ljktofly/-Aurix-/英飞凌 Aurix TC2XX_TC3XX学习板/TC2XX&TC3XX_主板原理图.pdf

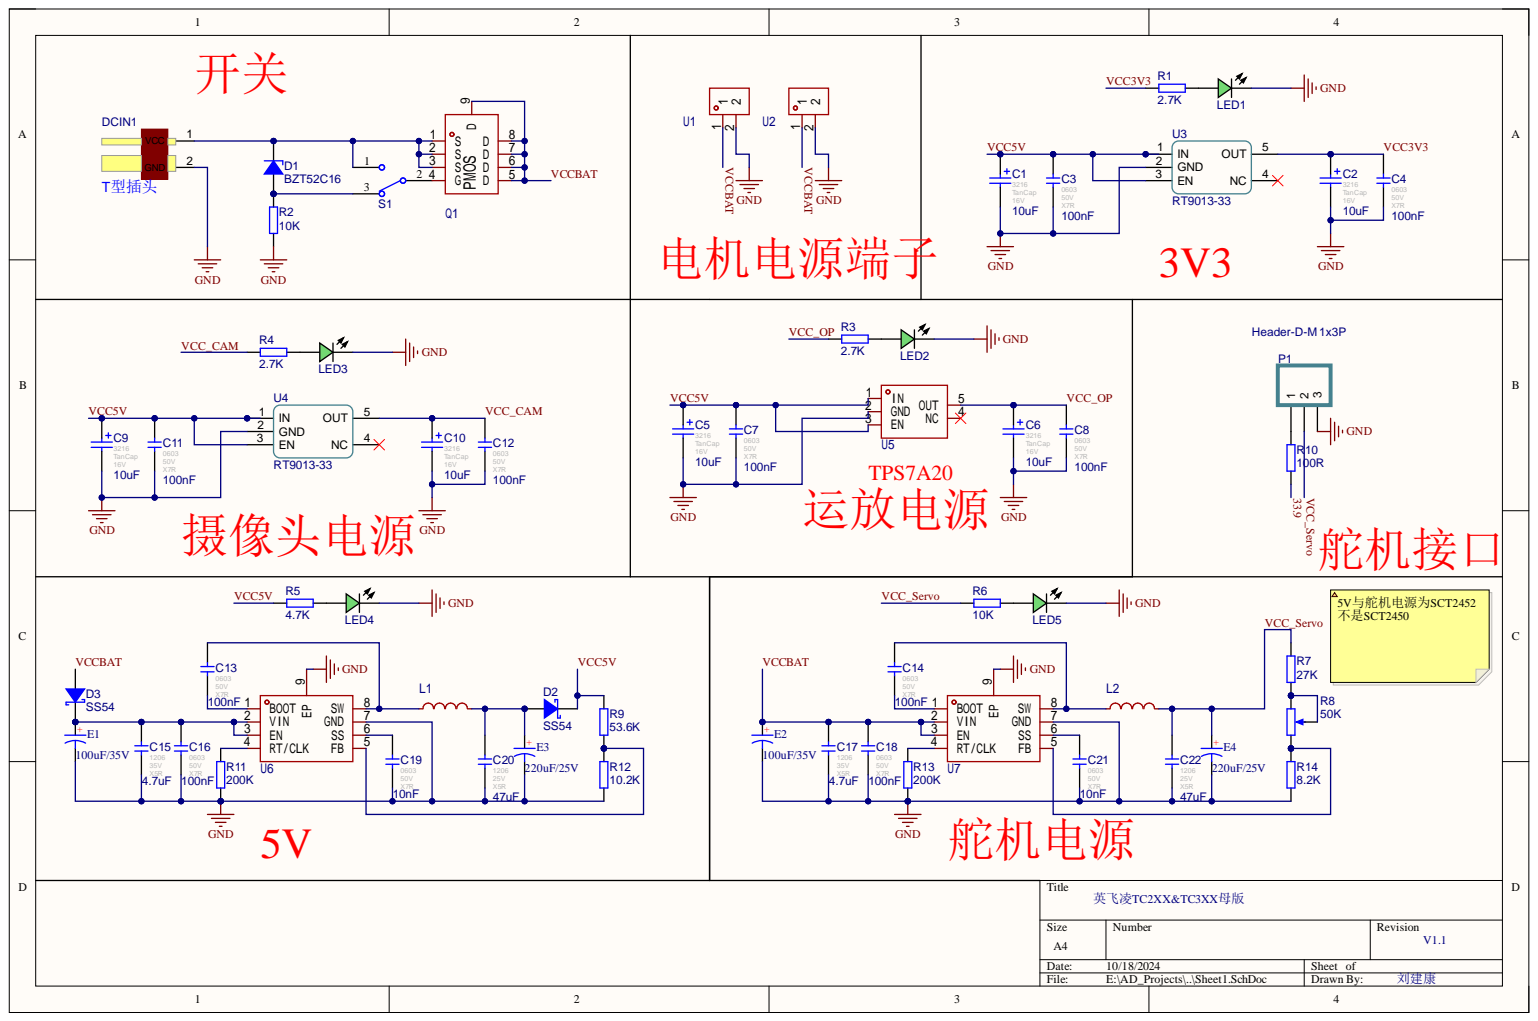
[picture p24: page 1]

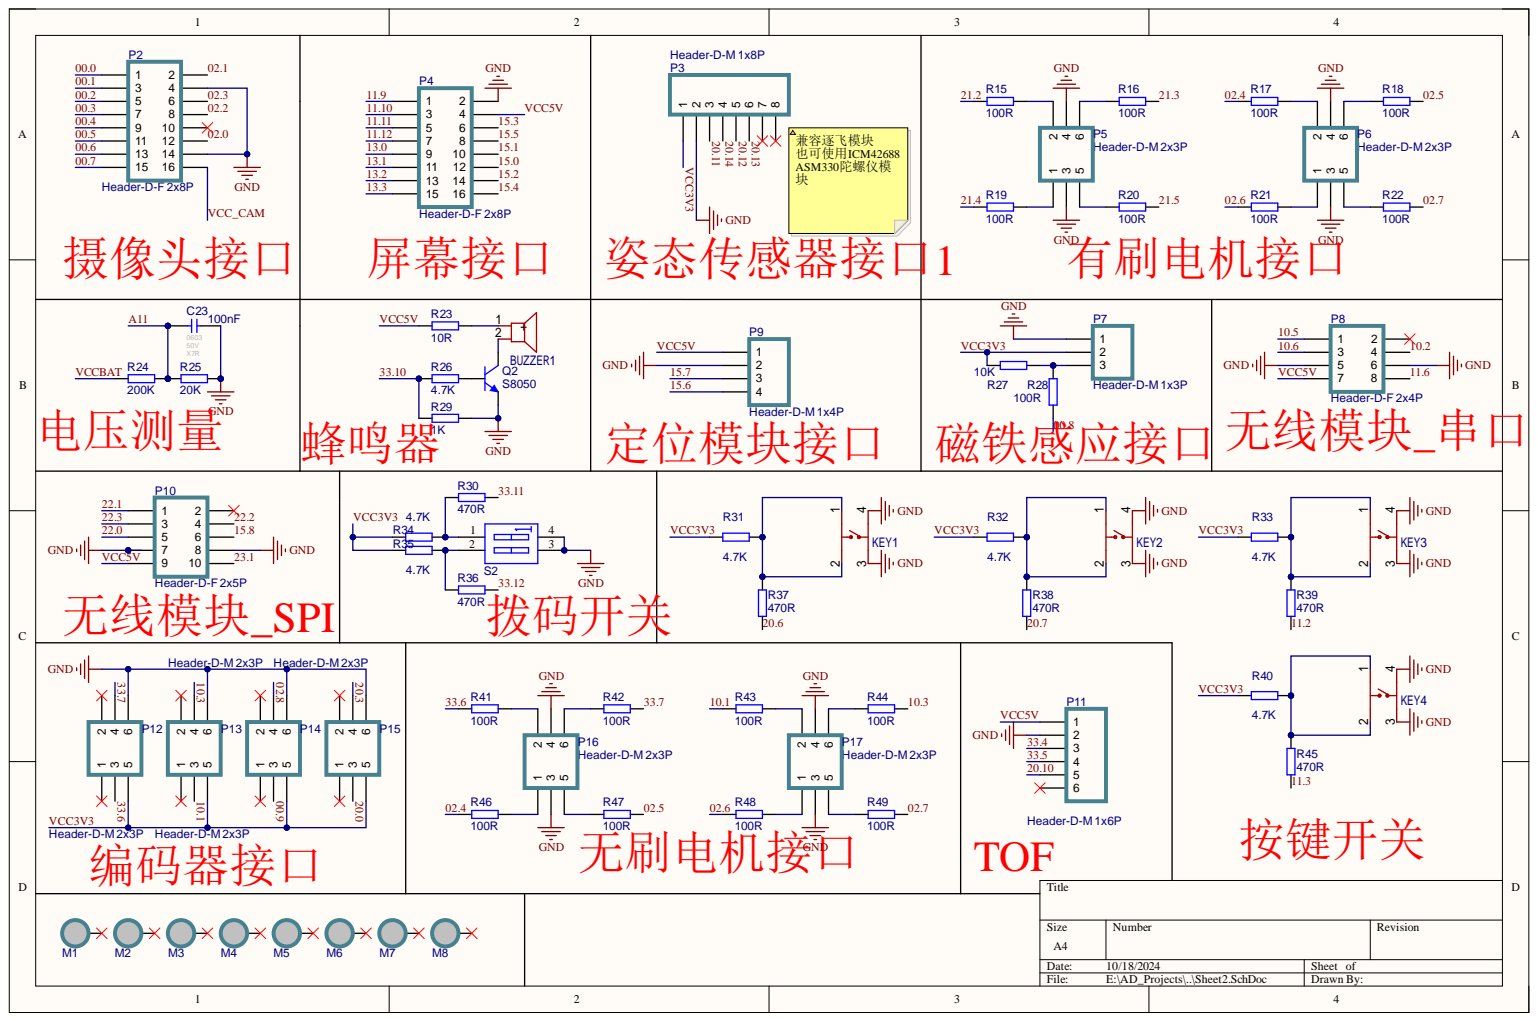
[picture p25: page 2]

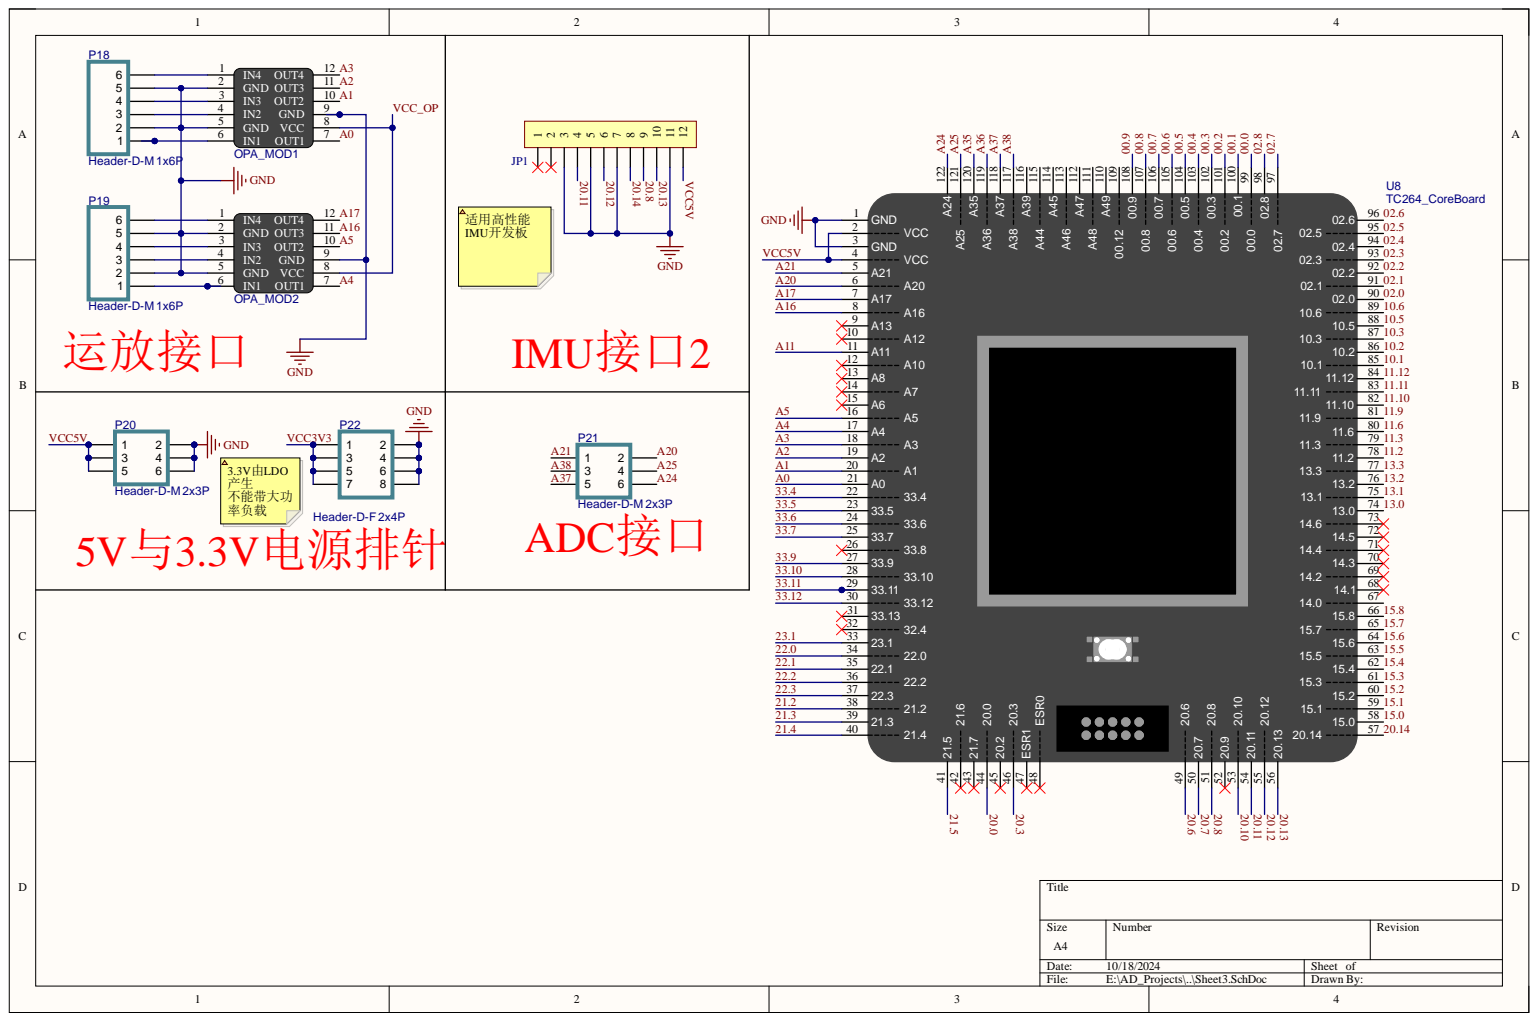
[picture p26: page 3]

3 1 0
4 9
