ljktofly/-Aurix-/英飞凌 Aurix TC2XX_TC3XX学习板/TC2XX&TC3XX_主板尺寸图.pdf

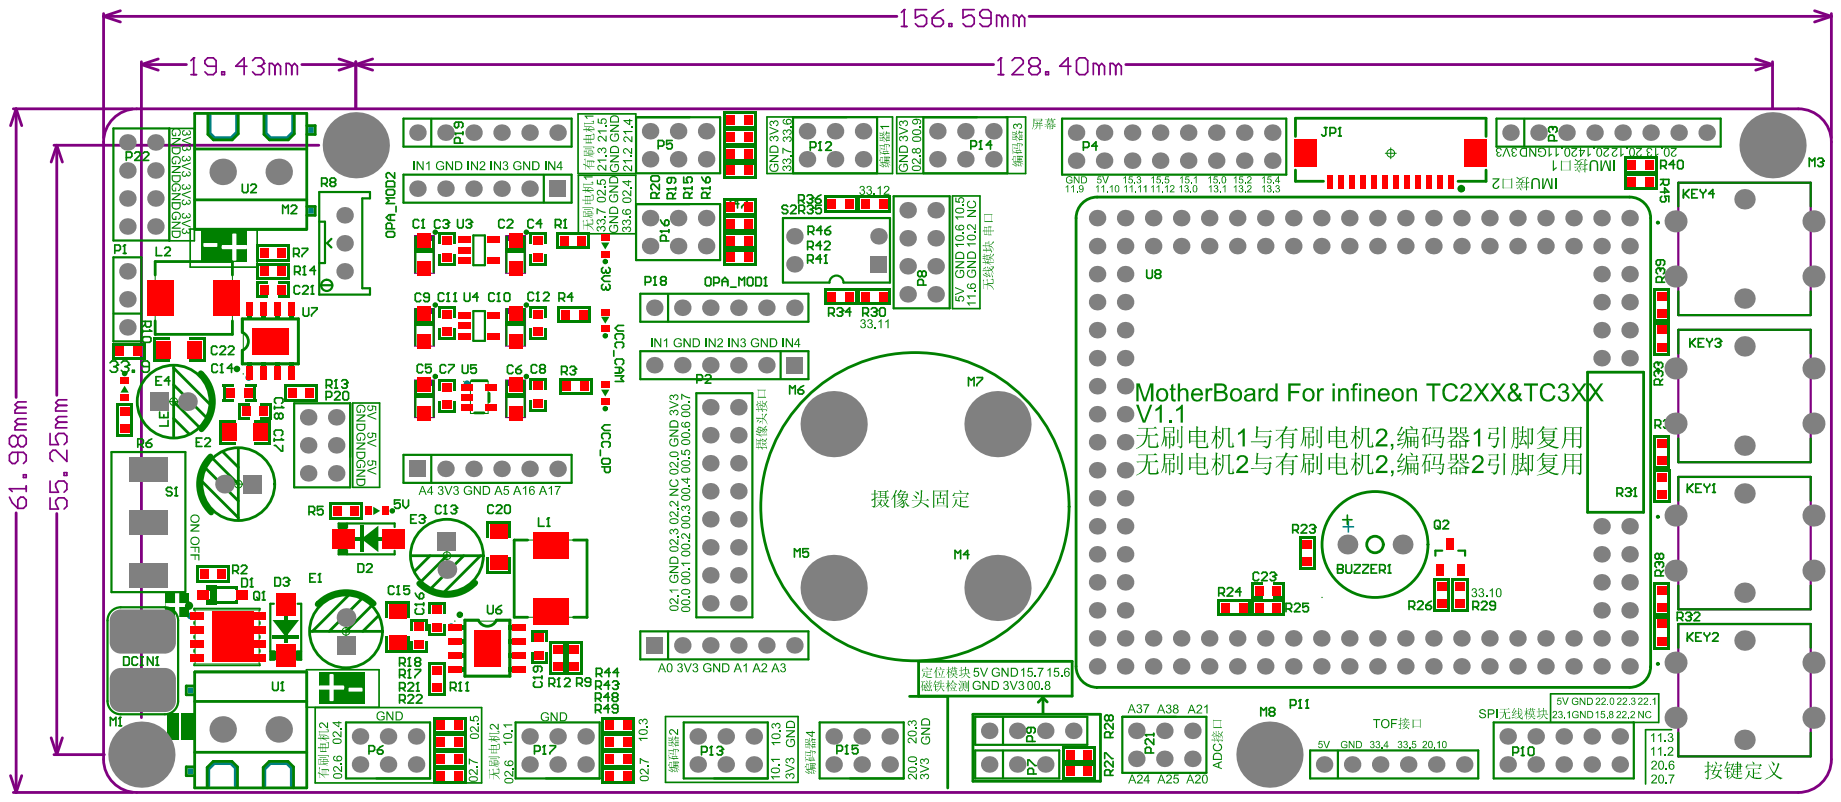
[picture p27: page 1]
