ljktofly/-Aurix-/英飞凌 Aurix TC2XX_TC3XX学习板/TC2XX&TC3XX_主板正面丝印_主板正面位号_主板背面丝印.pdf

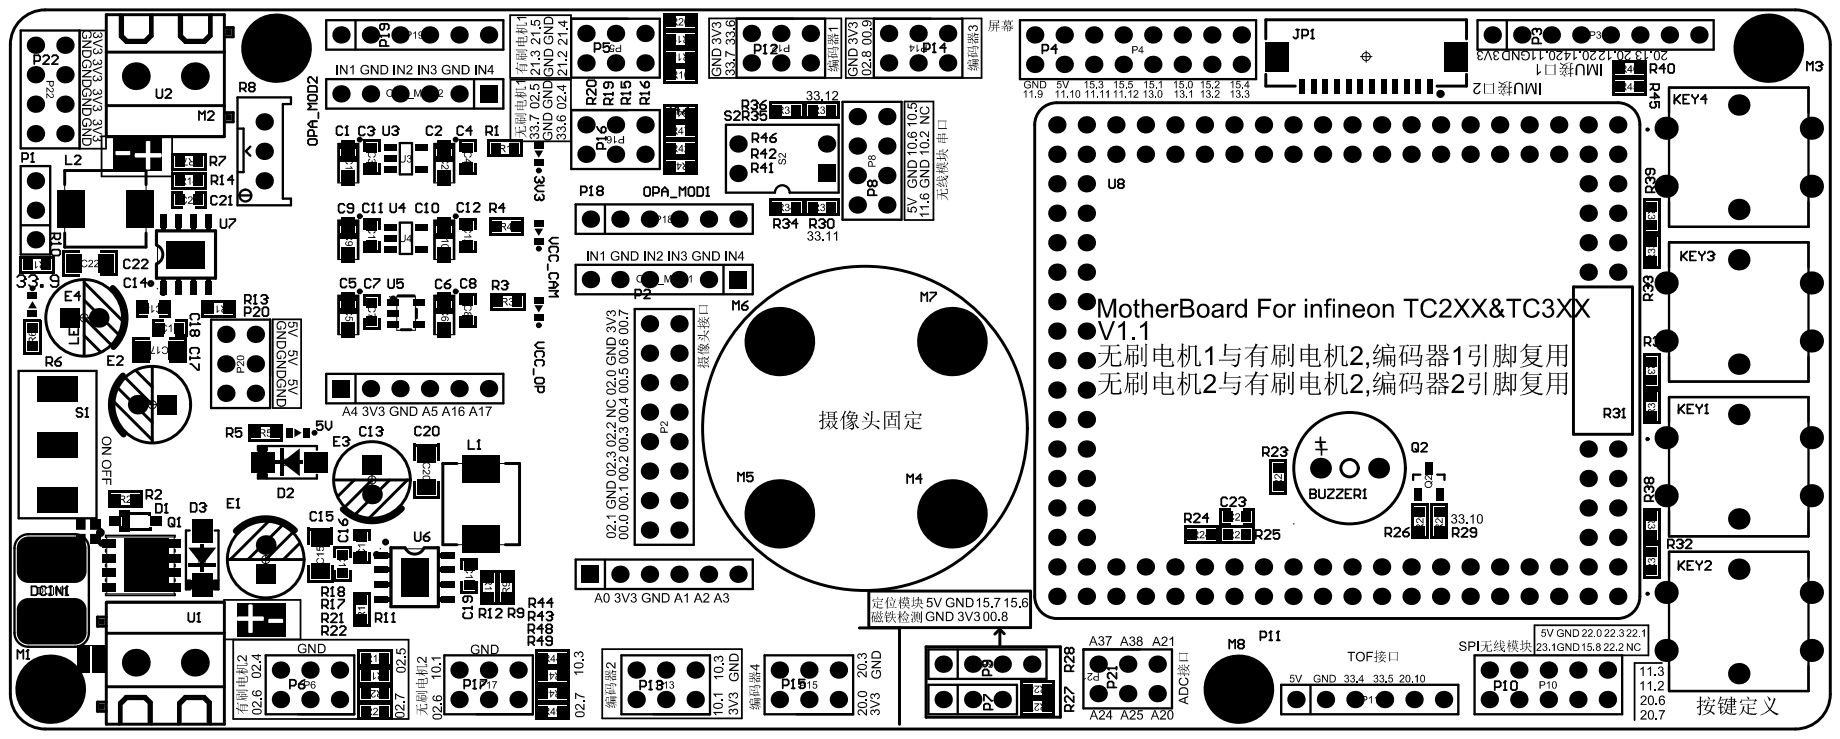
[picture p28: page 1]

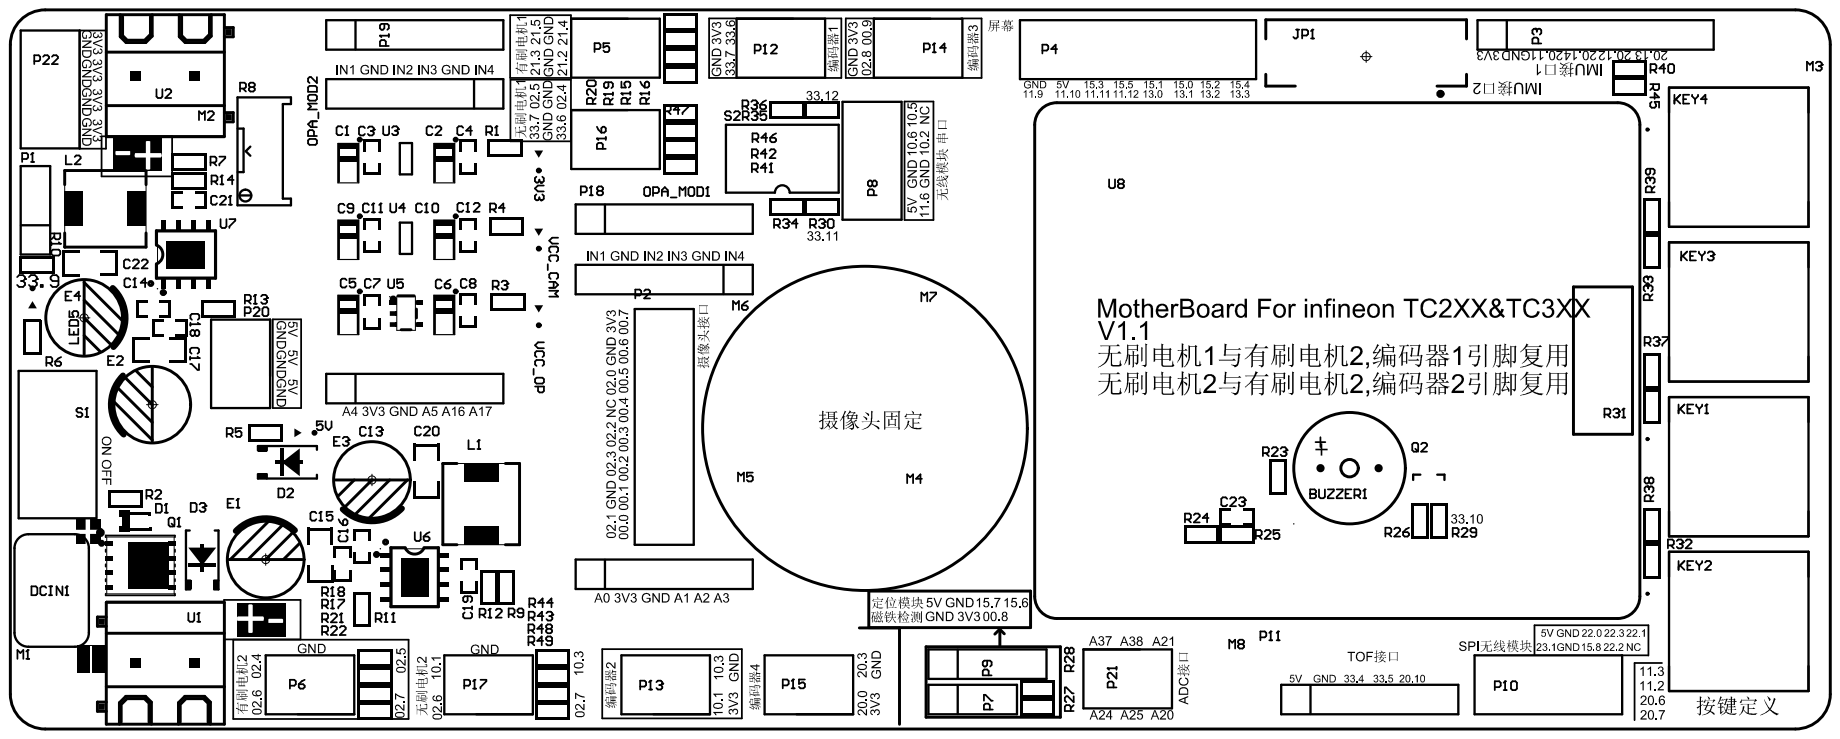
[picture p29: page 2]

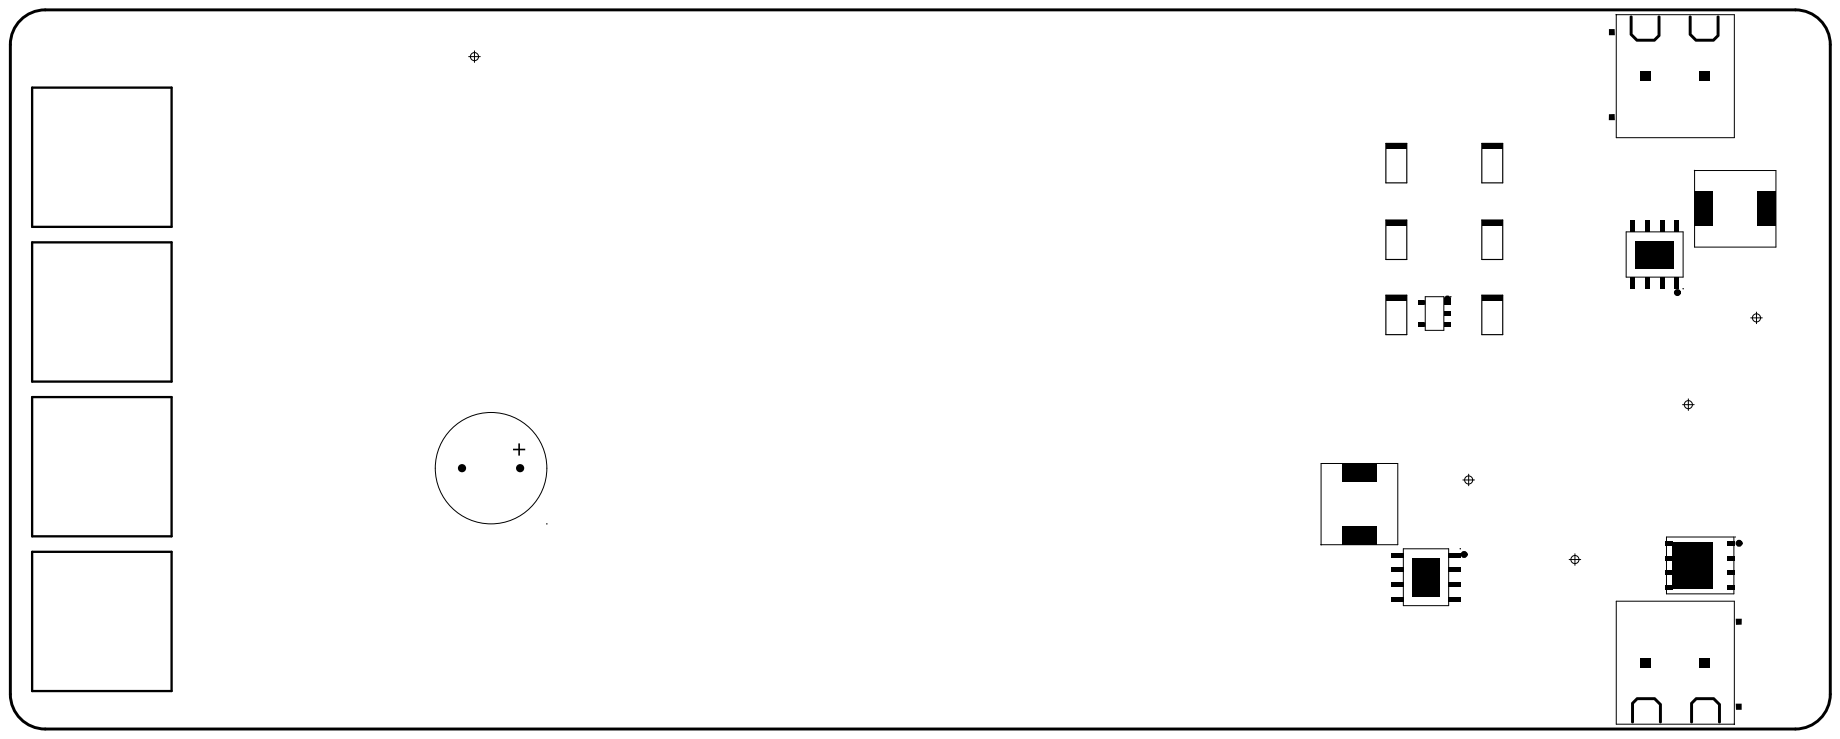
[picture p30: page 3]
