ljktofly/-Aurix-/(list of files, drawings)

Other design files:
英飞凌 Aurix TC2XX_TC3XX学习板/AD封装库/TC2XX&TC3XX_MotherBoard.PcbLib
英飞凌 Aurix TC2XX_TC3XX学习板/AD封装库/TC2XX&TC3XX_MotherBoard.SCHLIB
